roravec/Cibike_PWM/Cibike_PWM.X/docs/1379_control.brd

## EAGLE design Cibike_PWM.X/docs/1379_control.brd (2023-04-14)

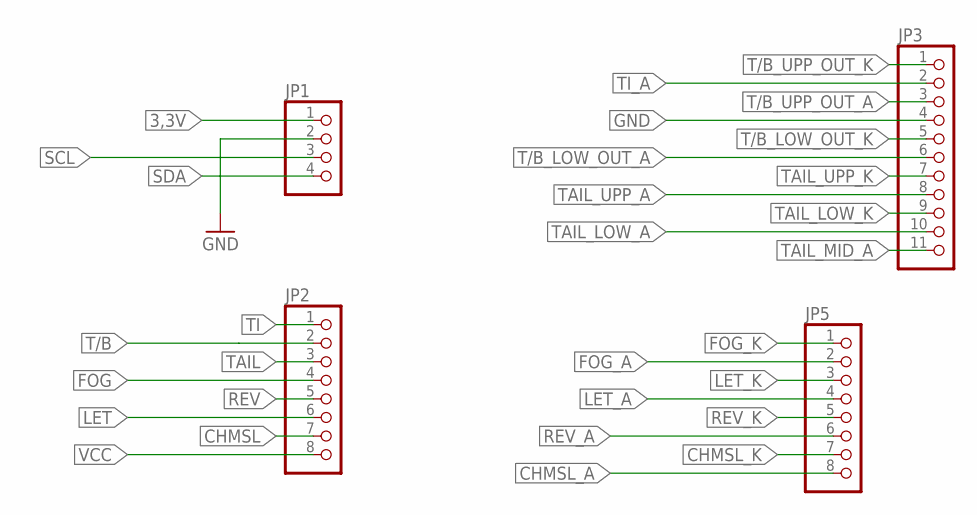
[picture p1: schematic 1379_control.sch, sheet 1]

Parts:
JP1: PINHD-1X4; 1X04
JP2, JP5: PINHD-1X8; 1X08
JP3: PINHD-1X11; 1X11

Connections:
3,3V: JP1.1; also elsewhere on the board
CHMSL: JP2.7; also elsewhere on the board
CHMSL_A: JP5.8; also elsewhere on the board
CHMSL_K: JP5.7; also elsewhere on the board
FOG: JP2.4; also elsewhere on the board
FOG_A: JP5.2; also elsewhere on the board
FOG_K: JP5.1; also elsewhere on the board
GND: JP1.2, JP3.4; also elsewhere on the board
LET: JP2.6; also elsewhere on the board
LET_A: JP5.4; also elsewhere on the board
LET_K: JP5.3; also elsewhere on the board
REV: JP2.5; also elsewhere on the board
REV_A: JP5.6; also elsewhere on the board
REV_K: JP5.5; also elsewhere on the board
SCL: JP1.3; also elsewhere on the board
SDA: JP1.4; also elsewhere on the board
T/B: JP2.2; also elsewhere on the board
T/B_LOW_OUT_A: JP3.6; also elsewhere on the board
T/B_LOW_OUT_K: JP3.5; also elsewhere on the board
T/B_UPP_OUT_A: JP3.3; also elsewhere on the board
T/B_UPP_OUT_K: JP3.1; also elsewhere on the board
TAIL: JP2.3; also elsewhere on the board
TAIL_LOW_A: JP3.10; also elsewhere on the board
TAIL_LOW_K: JP3.9; also elsewhere on the board
TAIL_MID_A: JP3.11; also elsewhere on the board
TAIL_UPP_A: JP3.8; also elsewhere on the board
TAIL_UPP_K: JP3.7; also elsewhere on the board
TI: JP2.1; also elsewhere on the board
TI_A: JP3.2; also elsewhere on the board
VCC: JP2.8; also elsewhere on the board

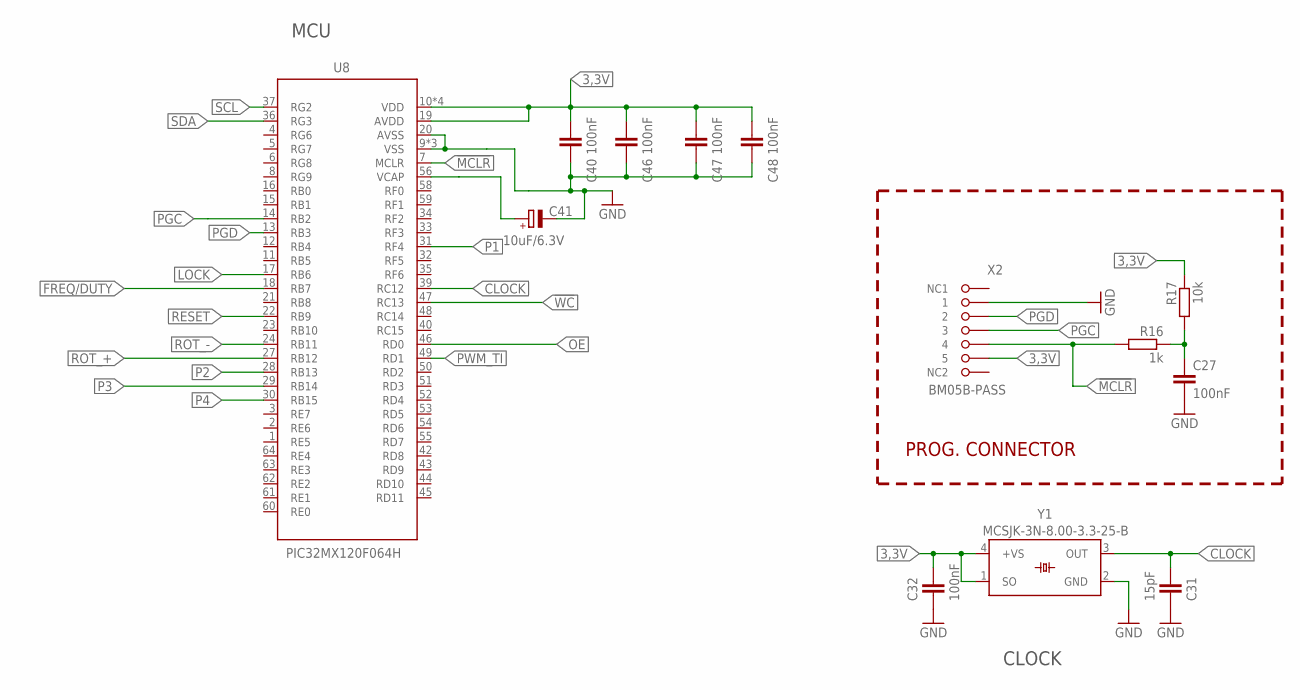
[picture p2: schematic 1379_control.sch, sheet 2]

Parts:
C27, C32, C40, C46, C47, C48: 100nF; C0603
C31: 15pF; C0603
C41: 10uF/6.3V; CT3216
R16: 1k; R0603
R17: 10k; R0603
U8: PIC32MX120F064H; PIC32MX-TQFN
X2: BM05B-PASS
Y1: MCSJK-3N-8.00-3.3-25-B; WE-SPXO_CFPS-104

Connections:
3,3V: C32.1, C40.1, C46.1, C47.1, C48.1, R17.1, U8.10 (VDD), U8.19 (AVDD), U8.26 (VDD), U8.38 (VDD), U8.57 (VDD), X2.P$5 (5), Y1.1 (SO), Y1.4 (+VS); also elsewhere on the board
!MCLR: R16.2, U8.7 (MCLR), X2.P$4 (4)
!WC: U8.47 (RC13); also elsewhere on the board
CLOCK: C31.1, U8.39 (RC12), Y1.3 (OUT)
FREQ/DUTY: U8.18 (RB7); also elsewhere on the board
GND: C27.2, C31.2, C32.2, C40.2, C41.-, C46.2, C47.2, C48.2, U8.9 (VSS), U8.20 (AVSS), U8.25 (VSS), U8.41 (VSS), X2.P$1 (1), Y1.2 (GND); also elsewhere on the board
LOCK: U8.17 (RB6); also elsewhere on the board
unnamed: C27.1, R16.1, R17.2
unnamed: C41.+, U8.56 (VCAP)
OE: U8.46 (RD0); also elsewhere on the board
P1: U8.31 (RF4); also elsewhere on the board
P2: U8.28 (RB13); also elsewhere on the board
P3: U8.29 (RB14); also elsewhere on the board
P4: U8.30 (RB15); also elsewhere on the board
PGC: U8.14 (RB2), X2.P$3 (3)
PGD: U8.13 (RB3), X2.P$2 (2)
PWM_TI: U8.49 (RD1); also elsewhere on the board
RE7: U8.3 (RE7)
RESET: U8.22 (RB9); also elsewhere on the board
ROT_+: U8.27 (RB12); also elsewhere on the board
ROT_-: U8.24 (RB11); also elsewhere on the board
SCL: U8.37 (RG2); also elsewhere on the board
SDA: U8.36 (RG3); also elsewhere on the board

Notes on the sheet:
PROG. CONNECTOR
MCU
CLOCK

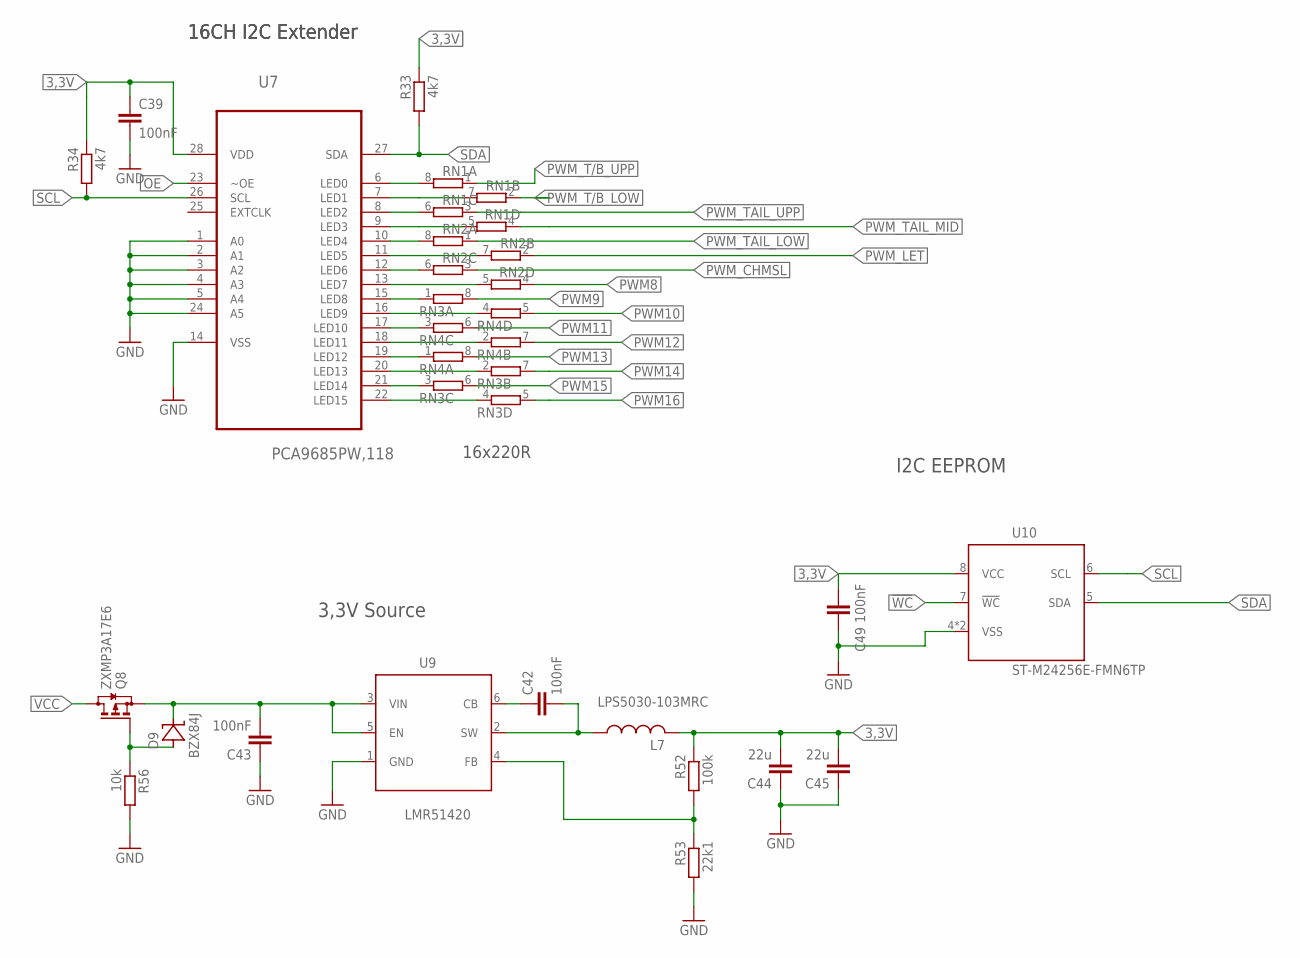
[picture p3: schematic 1379_control.sch, sheet 3]

Parts:
C39, C42, C43, C49: 100nF; C0603
C44, C45: 22u; C0603
D9: BZX84J; SOD323
L7: LPS5030-103MRC; L_5X5
Q8: ZXMP3A17E6; SOT23-6
R33, R34: 4k7; R0603
R52: 100k; R0603
R53: 22k1; R0603
R56: 10k; R0603
RN1, RN2, RN3, RN4: 4R-NEXBS8V; EXBS8V
U7: PCA9685PW,118; SOP65P640X110-28N
U9: LMR51420; SOT23-6
U10: ST-M24256E-FMN6TP; SO-8

Connections:
3,3V: C39.1, C44.2, C45.2, C49.1, L7.2, R33.1, R34.1, R52.1, U7.28 (VDD), U10.8 (VCC); also elsewhere on the board
!WC: U10.7 (!WC); also elsewhere on the board
GND: C39.2, C43.1, C44.1, C45.1, C49.2, R53.2, R56.2, U7.1 (A0), U7.2 (A1), U7.3 (A2), U7.4 (A3), U7.5 (A4), U7.14 (VSS), U7.24 (A5), U9.1 (GND), U10.4 (VSS), U10.EP (VSS); also elsewhere on the board
unnamed: RN1.8 (2), U7.6 (LED0)
unnamed: RN3.1, U7.15 (LED8)
unnamed: RN1.7 (2), U7.7 (LED1)
unnamed: RN4.4 (1), U7.16 (LED9)
unnamed: RN1.6 (2), U7.8 (LED2)
unnamed: RN4.3 (1), U7.17 (LED10)
unnamed: RN1.5 (2), U7.9 (LED3)
unnamed: RN2.8 (2), U7.10 (LED4)
unnamed: RN2.7 (2), U7.11 (LED5)
unnamed: RN2.6 (2), U7.12 (LED6)
unnamed: RN2.5 (2), U7.13 (LED7)
unnamed: RN4.2 (1), U7.18 (LED11)
unnamed: RN4.1, U7.19 (LED12)
unnamed: RN3.2 (1), U7.20 (LED13)
unnamed: RN3.3 (1), U7.21 (LED14)
unnamed: RN3.4 (1), U7.22 (LED15)
unnamed: R52.2, R53.1, U9.4 (FB)
unnamed: C42.2, L7.1, U9.2 (SW)
unnamed: C42.1, U9.6 (CB)
unnamed: D9.A, Q8.3 (G), R56.1
unnamed: C43.2, D9.C, Q8.4 (S), U9.3 (VIN), U9.5 (EN)
OE: U7.23 (~OE); also elsewhere on the board
PWM8: RN2.4 (1)
PWM9: RN3.8 (2)
PWM10: RN4.5 (2)
PWM11: RN4.6 (2)
PWM12: RN4.7 (2)
PWM13: RN4.8 (2)
PWM14: RN3.7 (2)
PWM15: RN3.6 (2)
PWM16: RN3.5 (2)
PWM_CHMSL: RN2.3 (1); also elsewhere on the board
PWM_LET: RN2.2 (1); also elsewhere on the board
PWM_T/B_LOW: RN1.2 (1); also elsewhere on the board
PWM_T/B_UPP: RN1.1; also elsewhere on the board
PWM_TAIL_LOW: RN2.1; also elsewhere on the board
PWM_TAIL_MID: RN1.4 (1); also elsewhere on the board
PWM_TAIL_UPP: RN1.3 (1); also elsewhere on the board
SCL: R34.2, U7.26 (SCL), U10.6 (SCL); also elsewhere on the board
SDA: R33.2, U7.27 (SDA), U10.5 (SDA); also elsewhere on the board
VCC: Q8.1 (D), Q8.2 (D), Q8.5 (D), Q8.6 (D); also elsewhere on the board

Notes on the sheet:
16x220R
16CH I2C Extender
I2C EEPROM
3,3V Source

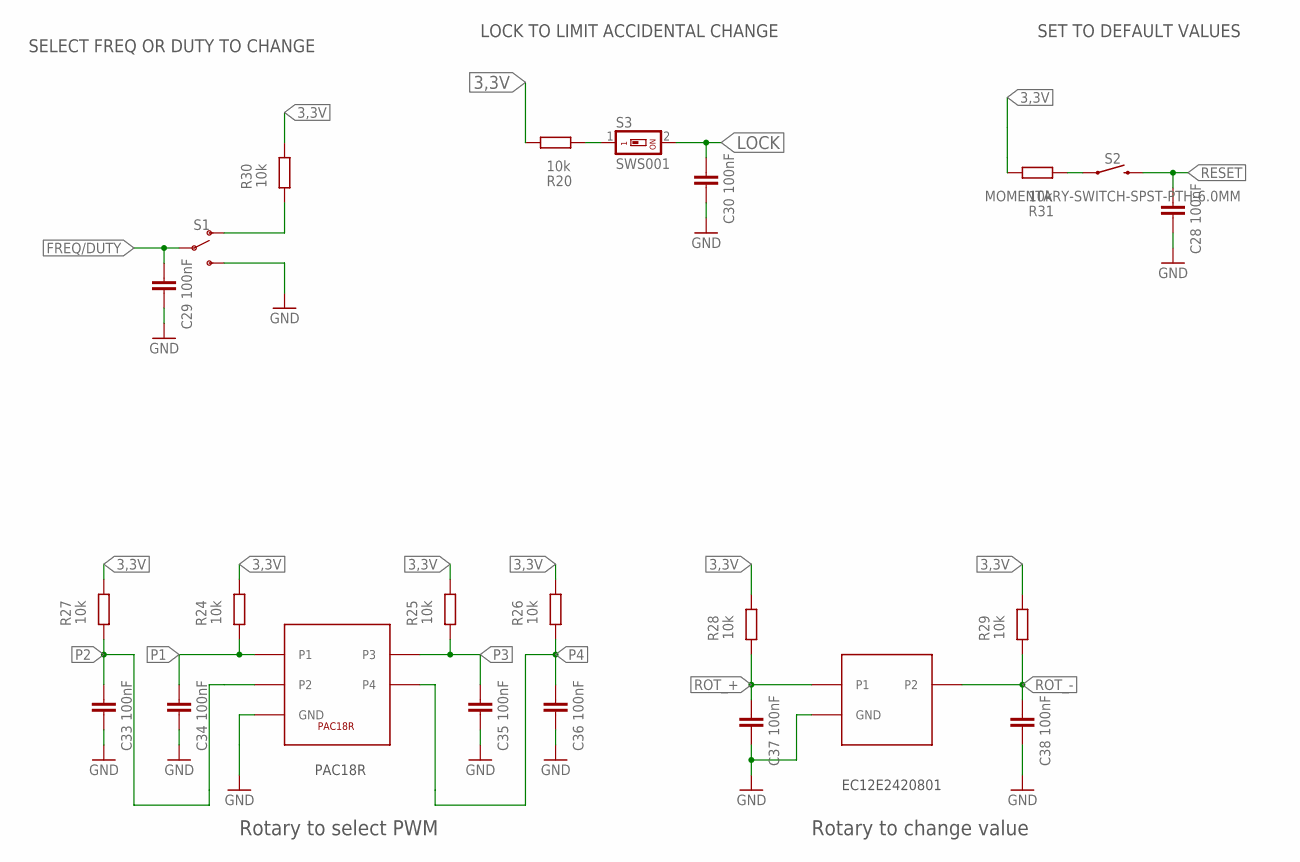
[picture p4: schematic 1379_control.sch, sheet 4]

Parts:
C28, C29, C30, C33, C34, C35, C36, C37, C38: 100nF; C0603
R20, R24, R25, R26, R27, R28, R29, R30, R31: 10k; R0603
S1: SWITCH-SPDT-PTH-11.6X4.0MM; SWITCH_SPDT_PTH_11.6X4.0MM
S2: MOMENTARY-SWITCH-SPST-PTH-6.0MM; TACTILE_SWITCH_PTH_6.0MM
S3: SWS001; SMS-001
X1: ENODER_ROTARY; ENCODER
X3: ENCODER-2

Connections:
3,3V: R20.1, R24.1, R25.1, R26.1, R27.1, R28.1, R29.1, R30.1, R31.1; also elsewhere on the board
FREQ/DUTY: C29.1, S1.2; also elsewhere on the board
GND: C28.2, C29.2, C30.2, C33.2, C34.2, C35.2, C36.2, C37.2, C38.2, S1.3 (S), X1.P$3 (GND), X3.P$2 (GND); also elsewhere on the board
LOCK: C30.1, S3.2; also elsewhere on the board
unnamed: R31.2, S2.1
unnamed: R30.2, S1.1 (O)
unnamed: R20.2, S3.1
P1: C34.1, R24.2, X1.P$5 (P1); also elsewhere on the board
P2: C33.1, R27.2, X1.P$1 (P2); also elsewhere on the board
P3: C35.1, R25.2, X1.P$4 (P3); also elsewhere on the board
P4: C36.1, R26.2, X1.P$2 (P4); also elsewhere on the board
RESET: C28.1, S2.3 (2); also elsewhere on the board
ROT_+: C37.1, R28.2, X3.P$1 (P1); also elsewhere on the board
ROT_-: C38.1, R29.2, X3.P$3 (P2); also elsewhere on the board

Notes on the sheet:
EC12E2420801
PAC18R
Rotary to select PWM
LOCK TO LIMIT ACCIDENTAL CHANGE
SELECT FREQ OR DUTY TO CHANGE
SET TO DEFAULT VALUES
Rotary to change value

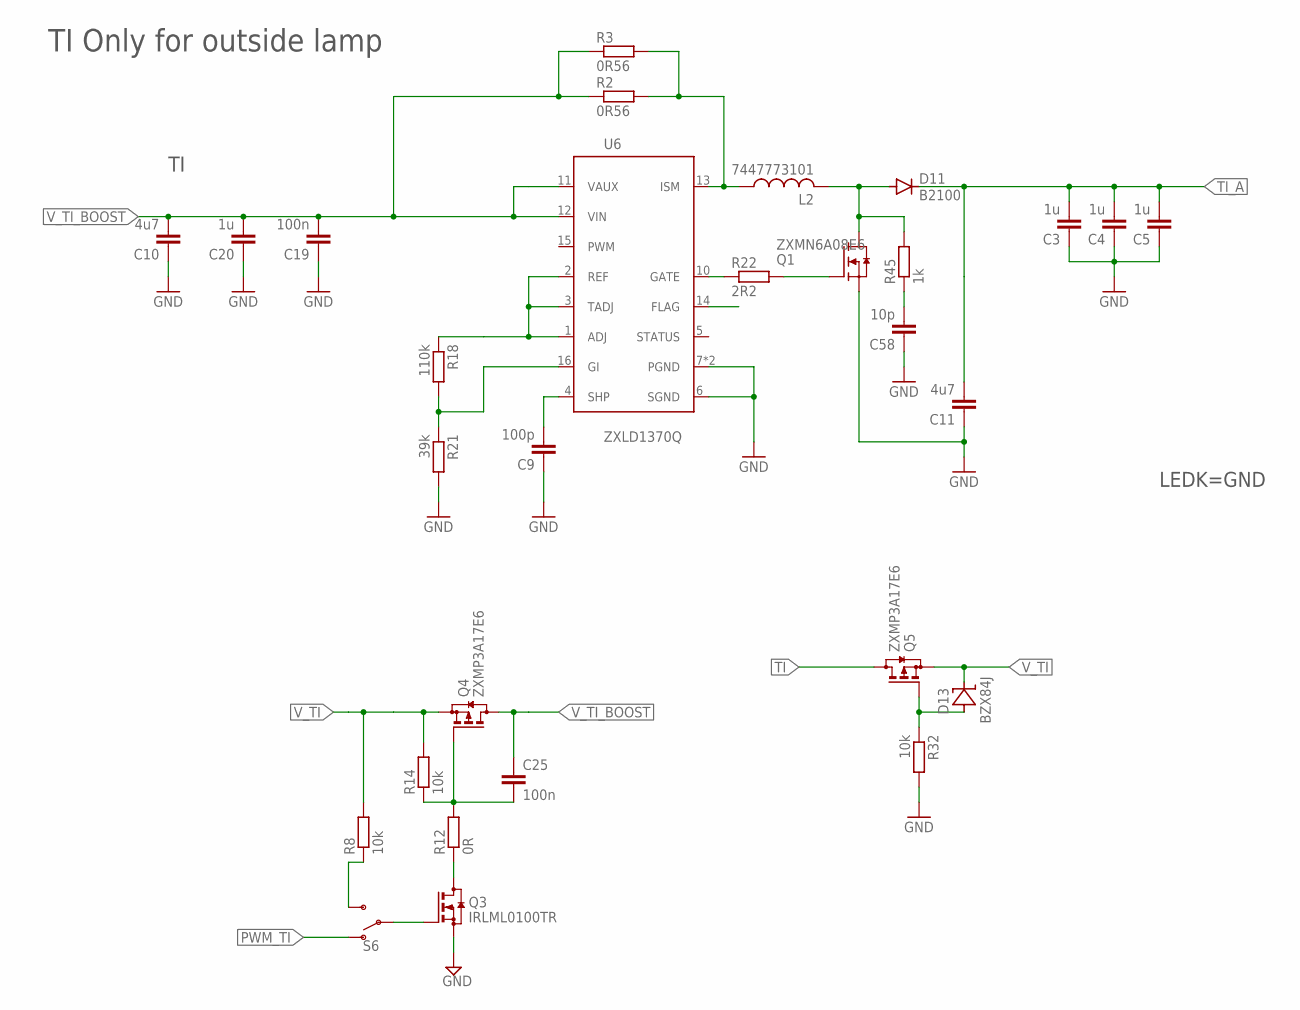
[picture p5: schematic 1379_control.sch, sheet 5]

Parts:
C3, C4, C5: 1u; C1206
C9: 100p; C0603
C10, C11: 4u7; C0603
C19, C25: 100n; C0603
C20: 1u; C0603
C58: 10p; C0603
D11: B2100; SMB
D13: BZX84J; SOD323
L2: 7447773101; L_7.4X7.4
Q1: ZXMN6A08E6; SOT23-6
Q3: IRLML0100TR; SOT23
Q4, Q5: ZXMP3A17E6; SOT23-6
R2, R3: 0R56; R0805
R8, R14, R32: 10k; R0603
R12: 0R; R0603
R18: 110k; R0603
R21: 39k; R0603
R22: 2R2; R0603
R45: 1k; R0603
S6: SWITCH-SPDT-PTH-11.6X4.0MM; SWITCH_SPDT_PTH_11.6X4.0MM
U6: ZXLD1370Q; TSSOP16E

Connections:
GND: C3.1, C4.1, C5.1, C9.1, C10.1, C11.1, C19.1, C20.1, C58.1, Q1.4 (S), Q3.2 (S), R21.2, R32.2, U6.6 (SGND), U6.7 (PGND), U6.EXP (PGND); also elsewhere on the board
unnamed: R8.1, S6.3 (S)
unnamed: C9.2, U6.4 (SHP)
unnamed: L2.1, R2.2, R3.2, U6.13 (ISM)
unnamed: D11.A, L2.2, Q1.1 (D), Q1.2 (D), Q1.5 (D), Q1.6 (D), R45.2
unnamed: R18.2, R21.1, U6.16 (GI)
unnamed: R18.1, U6.1 (ADJ), U6.2 (REF), U6.3 (TADJ)
unnamed: R22.1, U6.10 (GATE)
unnamed: Q1.3 (G), R22.2
unnamed: Q3.3 (D), R12.1
unnamed: C25.2, Q4.3 (G), R12.2, R14.1
unnamed: D13.A, Q5.3 (G), R32.1
unnamed: C58.2, R45.1
unnamed: Q3.1 (G), S6.2
PWM: U6.15 (PWM)
PWM_TI: S6.1 (O); also elsewhere on the board
TI: Q5.1 (D), Q5.2 (D), Q5.5 (D), Q5.6 (D); also elsewhere on the board
TI_A: C3.2, C4.2, C5.2, C11.2, D11.C; also elsewhere on the board
V_TI: D13.C, Q4.4 (S), Q5.4 (S), R8.2, R14.2
V_TI_BOOST: C10.2, C19.2, C20.2, C25.1, Q4.1 (D), Q4.2 (D), Q4.5 (D), Q4.6 (D), R2.1, R3.1, U6.11 (VAUX), U6.12 (VIN)

Notes on the sheet:
LEDK=GND
TI Only for outside lamp

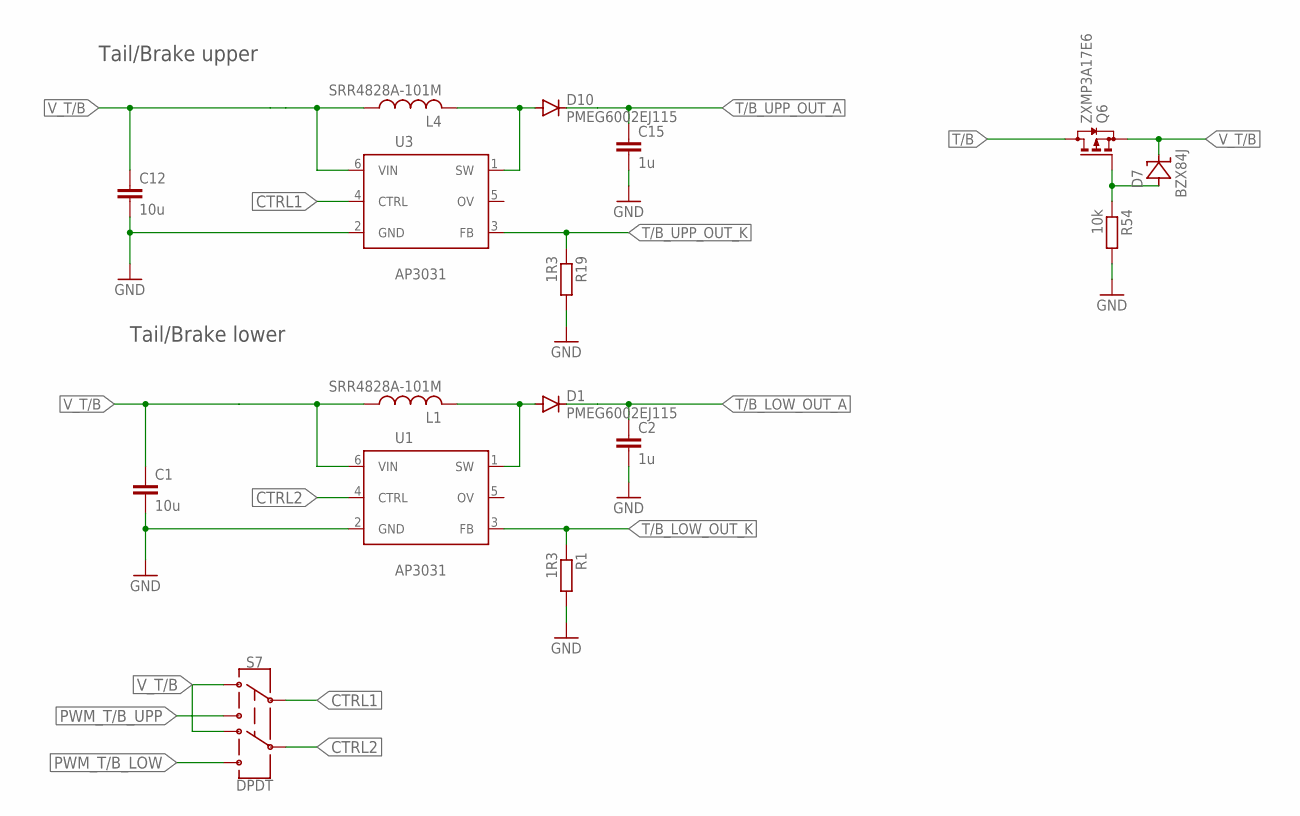
[picture p6: schematic 1379_control.sch, sheet 6]

Parts:
C1, C12: 10u; C0805
C2, C15: 1u; C0805
D1, D10: PMEG6002EJ115; SOD323-R
D7: BZX84J; SOD323
L1, L4: SRR4828A-101M; L_5X5
Q6: ZXMP3A17E6; SOT23-6
R1, R19: 1R3; R0805
R54: 10k; R0603
S7: DPDT; SWITCH_DPDT_PTH_GPI-152-3013
U1, U3: AP3031; SOT23-6

Connections:
CTRL1: S7.C@1 (2), U3.4 (CTRL)
CTRL2: S7.C@2 (5), U1.4 (CTRL)
GND: C1.2, C2.2, C12.2, C15.2, R1.2, R19.2, R54.2, U1.2 (GND), U3.2 (GND); also elsewhere on the board
unnamed: D1.A, L1.2, U1.1 (SW)
unnamed: D10.A, L4.2, U3.1 (SW)
unnamed: D7.A, Q6.3 (G), R54.1
PWM_T/B_LOW: S7.21 (6); also elsewhere on the board
PWM_T/B_UPP: S7.11 (3); also elsewhere on the board
T/B: Q6.1 (D), Q6.2 (D), Q6.5 (D), Q6.6 (D); also elsewhere on the board
T/B_LOW_OUT_A: C2.1, D1.C; also elsewhere on the board
T/B_LOW_OUT_K: R1.1, U1.3 (FB); also elsewhere on the board
T/B_UPP_OUT_A: C15.1, D10.C; also elsewhere on the board
T/B_UPP_OUT_K: R19.1, U3.3 (FB); also elsewhere on the board
V_T/B: C1.1, C12.1, D7.C, L1.1, L4.1, Q6.4 (S), S7.10 (1), S7.20 (4), U1.6 (VIN), U3.6 (VIN)

Notes on the sheet:
Tail/Brake upper
Tail/Brake lower

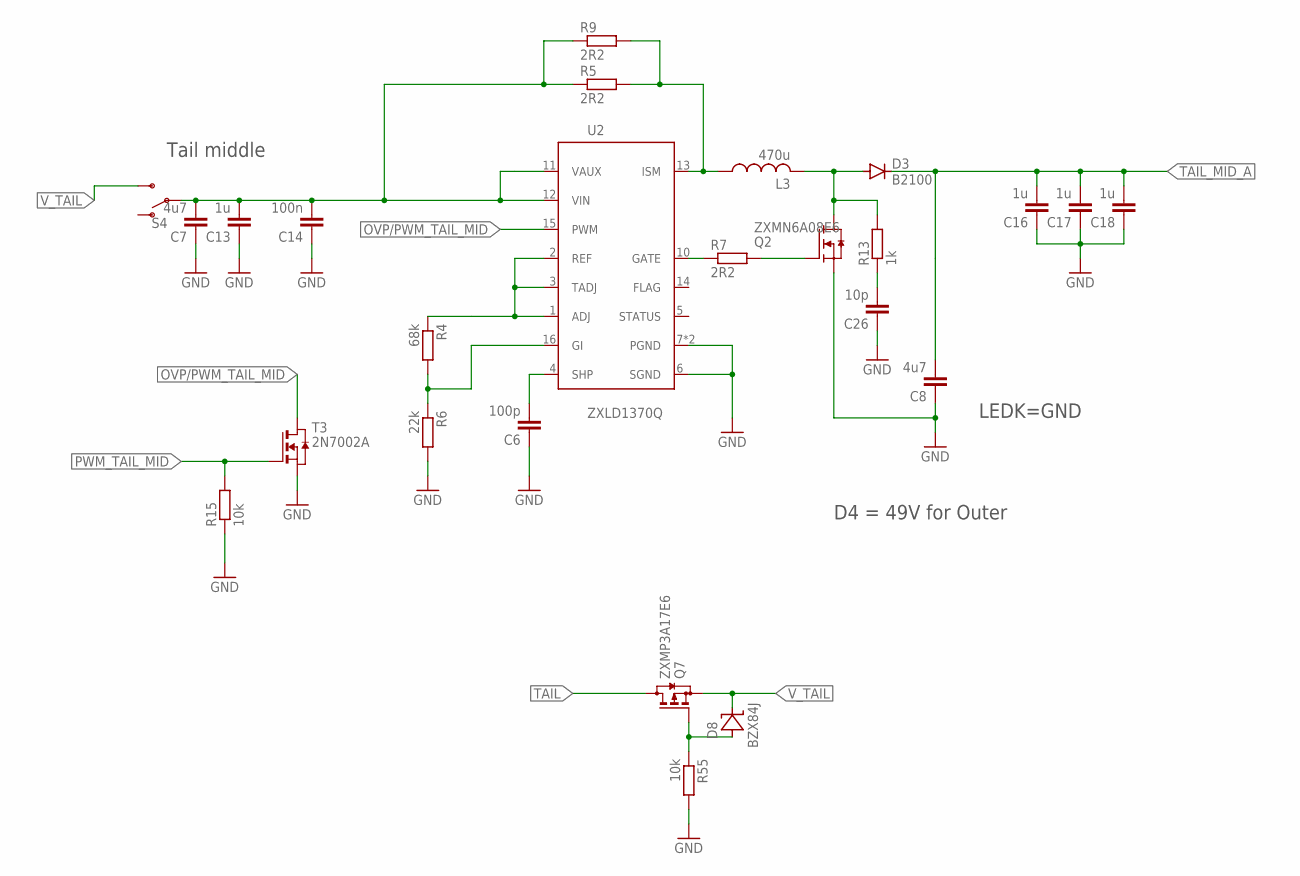
[picture p7: schematic 1379_control.sch, sheet 7]

Parts:
C6: 100p; C0603
C7, C8: 4u7; C0603
C13: 1u; C0603
C14: 100n; C0603
C16, C17, C18: 1u; C1206
C26: 10p; C0603
D3: B2100; SMB
D8: BZX84J; SOD323
L3: 470u; L_7.4X7.4
Q2: ZXMN6A08E6; SOT23-6
Q7: ZXMP3A17E6; SOT23-6
R4: 68k; R0603
R5, R9: 2R2; R0805
R6: 22k; R0603
R7: 2R2; R0603
R13: 1k; R0603
R15, R55: 10k; R0603
S4: SWITCH-SPDT-PTH-11.6X4.0MM; SWITCH_SPDT_PTH_11.6X4.0MM
T3: 2N7002A; SOT-23
U2: ZXLD1370Q; TSSOP16E

Connections:
FLAG: U2.14 (FLAG)
GND: C6.1, C7.1, C8.1, C13.1, C14.1, C16.1, C17.1, C18.1, C26.1, Q2.4 (S), R6.2, R15.1, R55.2, T3.2 (S), U2.6 (SGND), U2.7 (PGND), U2.EXP (PGND); also elsewhere on the board
unnamed: C6.2, U2.4 (SHP)
unnamed: L3.1, R5.2, R9.2, U2.13 (ISM)
unnamed: D3.A, L3.2, Q2.1 (D), Q2.2 (D), Q2.5 (D), Q2.6 (D), R13.2
unnamed: R4.2, R6.1, U2.16 (GI)
unnamed: R4.1, U2.1 (ADJ), U2.2 (REF), U2.3 (TADJ)
unnamed: R7.1, U2.10 (GATE)
unnamed: Q2.3 (G), R7.2
unnamed: C26.2, R13.1
unnamed: D8.A, Q7.3 (G), R55.1
OVP/PWM_TAIL_MID: T3.1 (D), U2.15 (PWM)
PWM_TAIL_MID: R15.2, T3.3 (G); also elsewhere on the board
TAIL: Q7.1 (D), Q7.2 (D), Q7.5 (D), Q7.6 (D); also elsewhere on the board
TAIL_MID_A: C8.2, C16.2, C17.2, C18.2, D3.C; also elsewhere on the board
V_TAIL: D8.C, Q7.4 (S), S4.3 (S); also elsewhere on the board
V_TAIL1: C7.2, C13.2, C14.2, R5.1, R9.1, S4.2, U2.11 (VAUX), U2.12 (VIN)

Notes on the sheet:
LEDK=GND
Tail middle
D4 = 49V for Outer

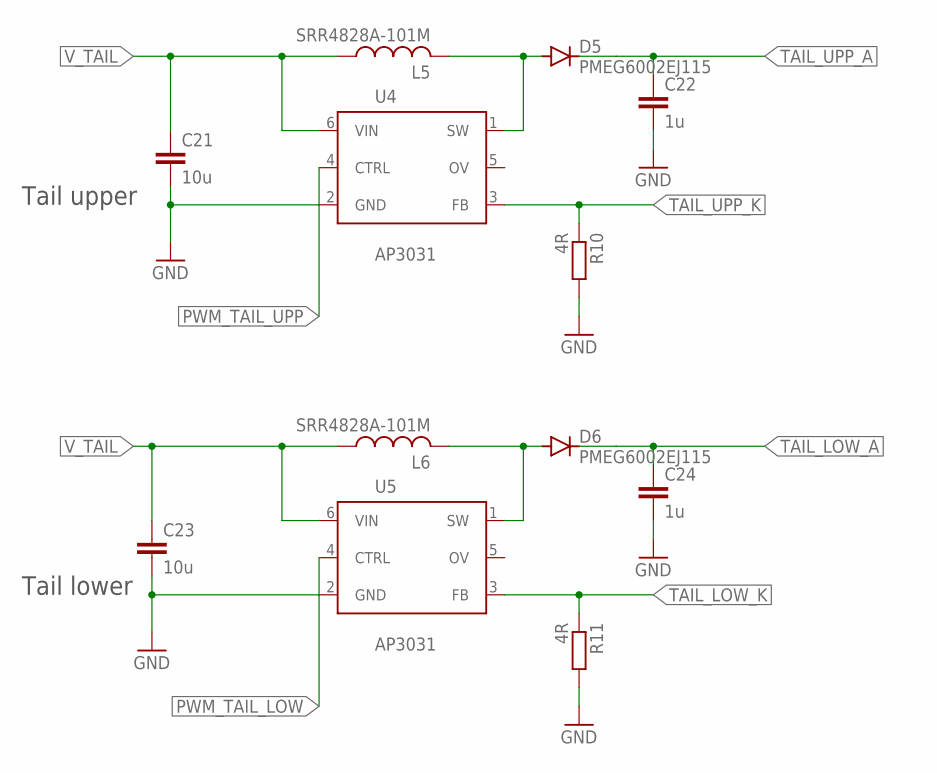
[picture p8: schematic 1379_control.sch, sheet 8]

Parts:
C21, C23: 10u; C0805
C22, C24: 1u; C0805
D5, D6: PMEG6002EJ115; SOD323-R
L5, L6: SRR4828A-101M; L_5X5
R10, R11: 4R; R0805
U4, U5: AP3031; SOT23-6

Connections:
GND: C21.2, C22.2, C23.2, C24.2, R10.2, R11.2, U4.2 (GND), U5.2 (GND); also elsewhere on the board
unnamed: D5.A, L5.2, U4.1 (SW)
unnamed: D6.A, L6.2, U5.1 (SW)
PWM_TAIL_LOW: U5.4 (CTRL); also elsewhere on the board
PWM_TAIL_UPP: U4.4 (CTRL); also elsewhere on the board
TAIL_LOW_A: C24.1, D6.C; also elsewhere on the board
TAIL_LOW_K: R11.1, U5.3 (FB); also elsewhere on the board
TAIL_UPP_A: C22.1, D5.C; also elsewhere on the board
TAIL_UPP_K: R10.1, U4.3 (FB); also elsewhere on the board
V_TAIL: C21.1, C23.1, L5.1, L6.1, U4.6 (VIN), U5.6 (VIN); also elsewhere on the board

Notes on the sheet:
Tail upper
Tail lower

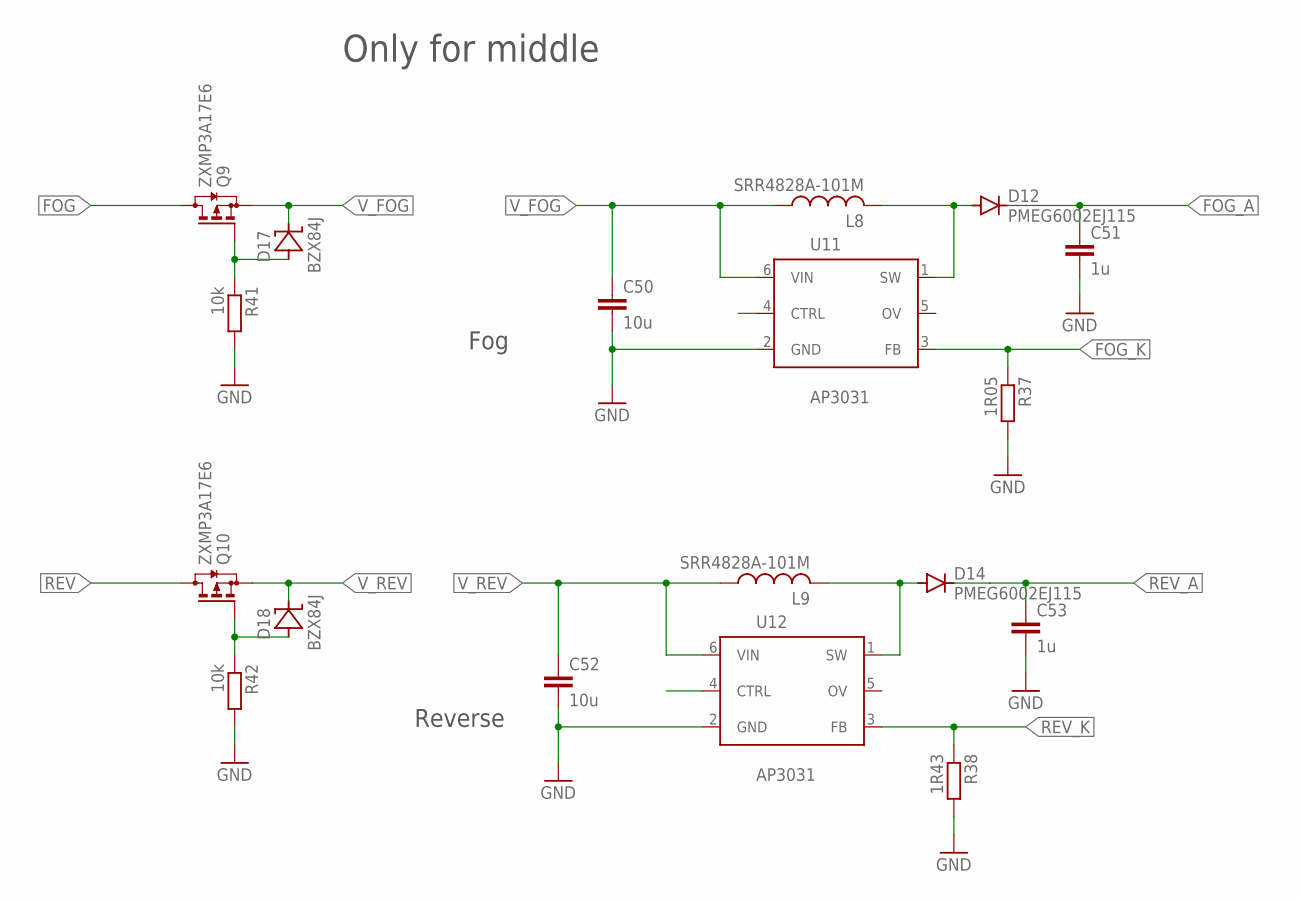
[picture p9: schematic 1379_control.sch, sheet 9]

Parts:
C50, C52: 10u; C0805
C51, C53: 1u; C0805
D12, D14: PMEG6002EJ115; SOD323-R
D17, D18: BZX84J; SOD323
L8, L9: SRR4828A-101M; L_5X5
Q9, Q10: ZXMP3A17E6; SOT23-6
R37: 1R05; R0805
R38: 1R43; R0805
R41, R42: 10k; R0603
U11, U12: AP3031; SOT23-6

Connections:
FOG: Q9.1 (D), Q9.2 (D), Q9.5 (D), Q9.6 (D); also elsewhere on the board
FOG_A: C51.1, D12.C; also elsewhere on the board
FOG_K: R37.1, U11.3 (FB); also elsewhere on the board
GND: C50.2, C51.2, C52.2, C53.2, R37.2, R38.2, R41.2, R42.2, U11.2 (GND), U12.2 (GND); also elsewhere on the board
unnamed: D12.A, L8.2, U11.1 (SW)
unnamed: D14.A, L9.2, U12.1 (SW)
unnamed: D17.A, Q9.3 (G), R41.1
unnamed: D18.A, Q10.3 (G), R42.1
REV: Q10.1 (D), Q10.2 (D), Q10.5 (D), Q10.6 (D); also elsewhere on the board
REV_A: C53.1, D14.C; also elsewhere on the board
REV_K: R38.1, U12.3 (FB); also elsewhere on the board
V_FOG: C50.1, D17.C, L8.1, Q9.4 (S), U11.6 (VIN)
V_REV: C52.1, D18.C, L9.1, Q10.4 (S), U12.6 (VIN)

Notes on the sheet:
Fog
Reverse
Only for middle

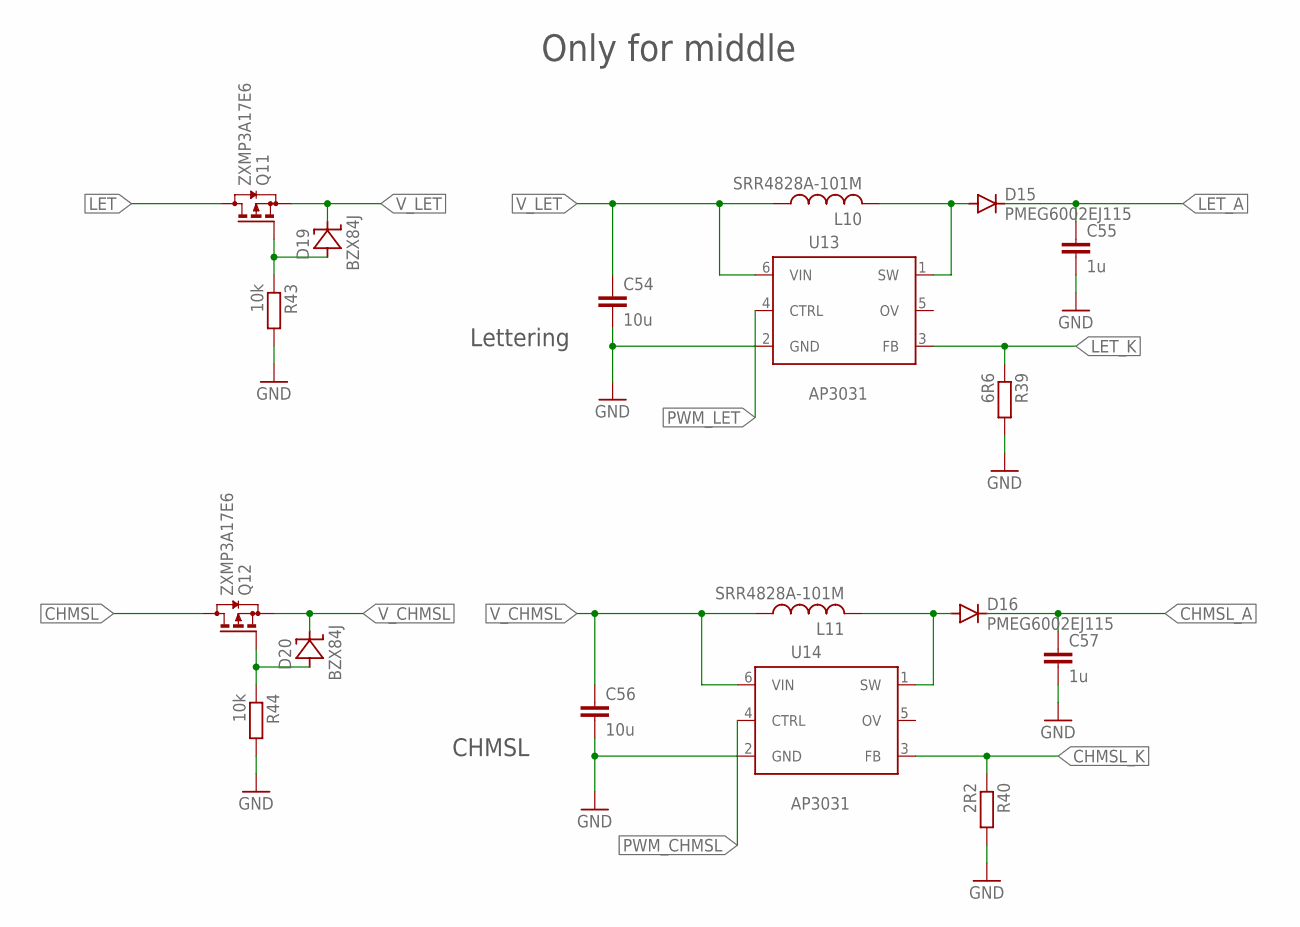
[picture p10: schematic 1379_control.sch, sheet 10]

Parts:
C54, C56: 10u; C0805
C55, C57: 1u; C0805
D15, D16: PMEG6002EJ115; SOD323-R
D19, D20: BZX84J; SOD323
L10, L11: SRR4828A-101M; L_5X5
Q11, Q12: ZXMP3A17E6; SOT23-6
R39: 6R6; R0805
R40: 2R2; R0805
R43, R44: 10k; R0603
U13, U14: AP3031; SOT23-6

Connections:
CHMSL: Q12.1 (D), Q12.2 (D), Q12.5 (D), Q12.6 (D); also elsewhere on the board
CHMSL_A: C57.1, D16.C; also elsewhere on the board
CHMSL_K: R40.1, U14.3 (FB); also elsewhere on the board
GND: C54.2, C55.2, C56.2, C57.2, R39.2, R40.2, R43.2, R44.2, U13.2 (GND), U14.2 (GND); also elsewhere on the board
LET: Q11.1 (D), Q11.2 (D), Q11.5 (D), Q11.6 (D); also elsewhere on the board
LET_A: C55.1, D15.C; also elsewhere on the board
LET_K: R39.1, U13.3 (FB); also elsewhere on the board
unnamed: D15.A, L10.2, U13.1 (SW)
unnamed: D16.A, L11.2, U14.1 (SW)
unnamed: D19.A, Q11.3 (G), R43.1
unnamed: D20.A, Q12.3 (G), R44.1
PWM_CHMSL: U14.4 (CTRL); also elsewhere on the board
PWM_LET: U13.4 (CTRL); also elsewhere on the board
V_CHMSL: C56.1, D20.C, L11.1, Q12.4 (S), U14.6 (VIN)
V_LET: C54.1, D19.C, L10.1, Q11.4 (S), U13.6 (VIN)

Notes on the sheet:
Lettering
CHMSL
Only for middle

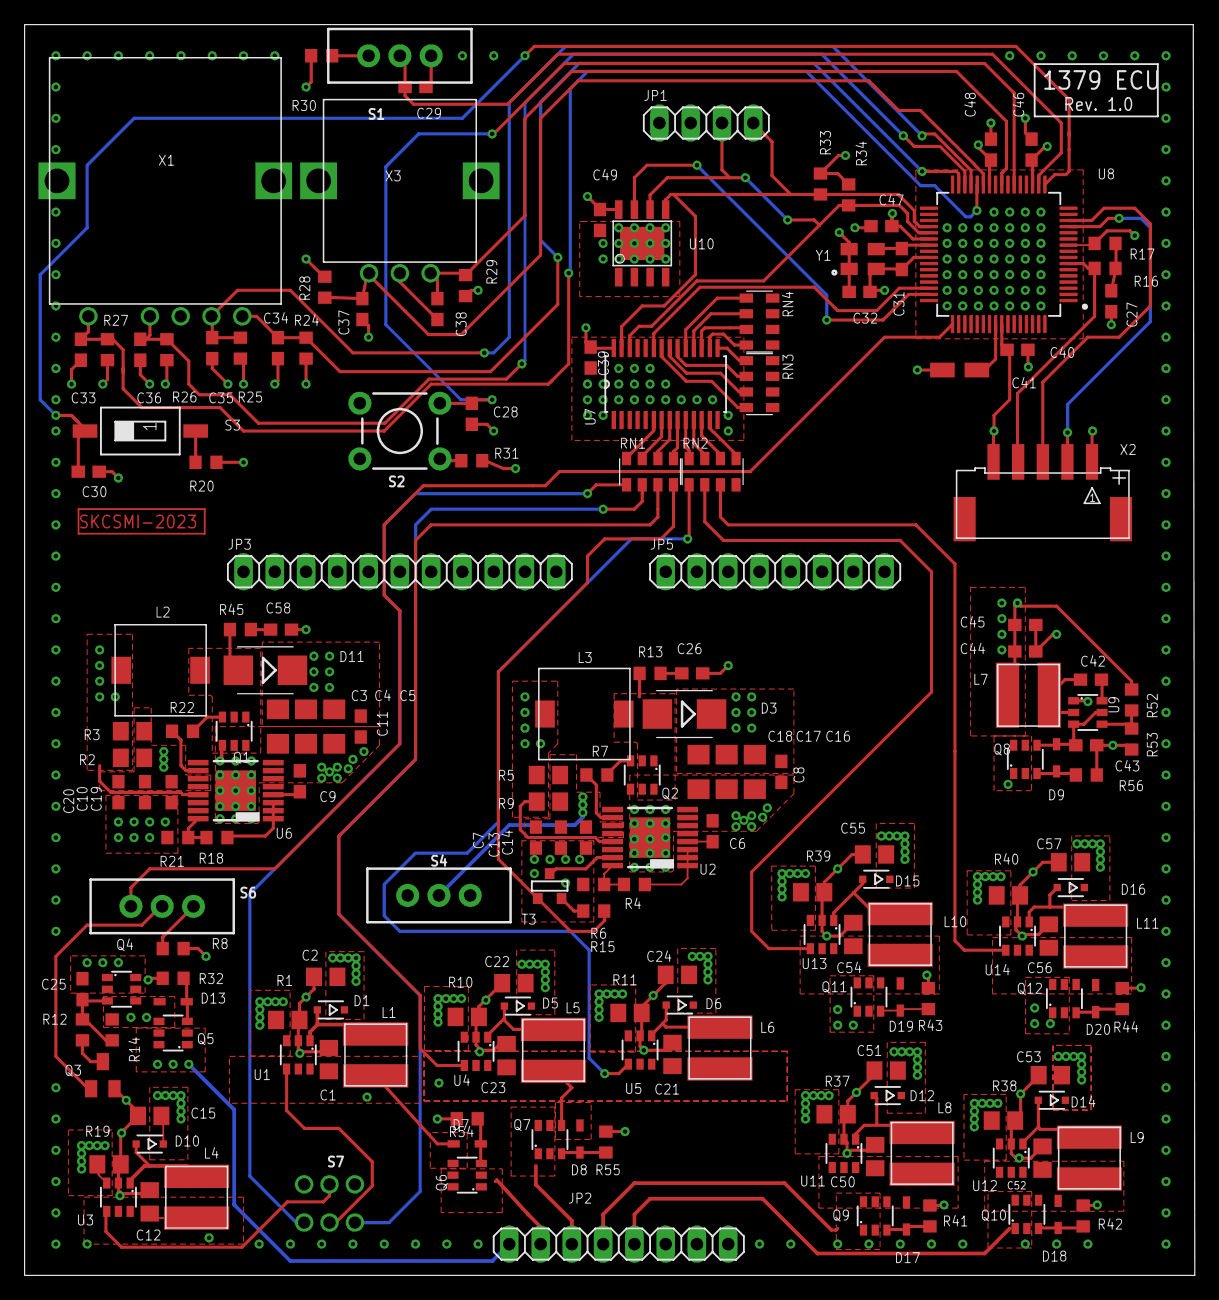
[picture p11: board 1379_control.brd from above]

Board: 4 copper layers, 95.0 x 101.6 mm, 179 parts (0 on the bottom side), 126 nets.
