roravec/Cibike_PWM/Cibike_PWM.X/i2c_display.h

/* 
 * File:   i2c_diplay.h
 * Author: orras
 *
 * Created on April 15, 2023, 3:03 PM
 */

#ifndef I2C_DIPLAY_H
#define	I2C_DIPLAY_H

#define LCD_ADDRESS             0x4E

#define LCD_BACKLIGHT           0x08
#define LCD_NOBACKLIGHT         0x00
#define LCD_FIRST_ROW           0x80
#define LCD_SECOND_ROW          0xC0
#define LCD_THIRD_ROW           0x94
#define LCD_FOURTH_ROW          0xD4
#define LCD_CLEAR               0x01
#define LCD_RETURN_HOME         0x02
#define LCD_ENTRY_MODE_SET      0x04
#define LCD_CURSOR_OFF          0x0C
#define LCD_UNDERLINE_ON        0x0E
#define LCD_BLINK_CURSOR_ON     0x0F
#define LCD_MOVE_CURSOR_LEFT    0x10
#define LCD_MOVE_CURSOR_RIGHT   0x14
#define LCD_TURN_ON             0x0C
#define LCD_TURN_OFF            0x08
#define LCD_SHIFT_LEFT          0x18
#define LCD_SHIFT_RIGHT         0x1E
#define LCD_TYPE                2       // 0 -> 5x7 | 1 -> 5x10 | 2 -> 2 lines

#include <xc.h>
#include "i2c.h"

#ifdef	__cplusplus
extern "C" {
#endif

    void LCD_Init(void);
    void LCD_IO_Expander_Write(uint8_t Data);
    void LCD_Write_4Bit(uint8_t Nibble);
    void LCD_CMD(uint8_t CMD);
    void LCD_Set_Cursor(uint8_t ROW, uint8_t COL);
    void LCD_Write_Char(uint8_t);
    void LCD_Write_String(uint8_t*);
    void LCD_Backlight(void);
    void LCD_NoBacklight(void);
    void LCD_SR(void);
    void LCD_SL(void);
    void LCD_Clear(void);


#ifdef	__cplusplus
}
#endif

#endif	/* I2C_DIPLAY_H */
