roravec/Cibike_PWM/(commit log)

2023-04-03 init 2
    [1379_control.sch]
2023-04-14 New layout
    [1379_control.brd, 1379_control.sch]
2023-04-20 PWM works
